NZX37/ESP32Musicplayer/BOM.csv

Item | Qty | Supplier | Cost/item | Total Cost | link
2.25 Inch 2.8V-3.3V TFT LCD Screen ST7789 | 1 | Aliexpress | $6.05 | $6.05 | https://www.aliexpress.com/item/1005009266053584.html
Waveshare ESP32-S3-WROOM-1-N8R8 microcontroller | 1 | Waveshare | $16.88 | $16.88 | https://www.berrybase.de/en/waveshare-esp32-s3-wroom-1-n8r8-microcontroller-aiot-wi-fi-bt-ble-240mhz-dual-core-without-header
PCM5102 I2S DAC with Line Level Output - 112dB SNR | 1 | Adafruit | $4.95 | $4.95 | https://www.adafruit.com/product/6250
DC-DC Step Up Boost Converter | 1 | Kuriosity | $4.40 | $4.40 | https://kuriosity.sg/products/dc-dc-step-up-boost-converter-2-5-vout-to-5-12v-1a-5w
CONN JACK STEREO 3.5MM R/A | 1 | Digikey | $2.22 | $2.22 | https://www.digikey.sg/en/products/detail/same-sky-formerly-cui-devices/SJ1-3535NG/738699
PCB | 1 | JLCPCB | $2.00 | $2.00 | https://jlcpcb.com
PCBA | 1 | jlcpcb | $29.83 | $29.83 | https://jlcpcb.com
Estimated total shipping | 1 |  |  | $0.00
