NZX37/ESP32Musicplayer/Case/LID.stl

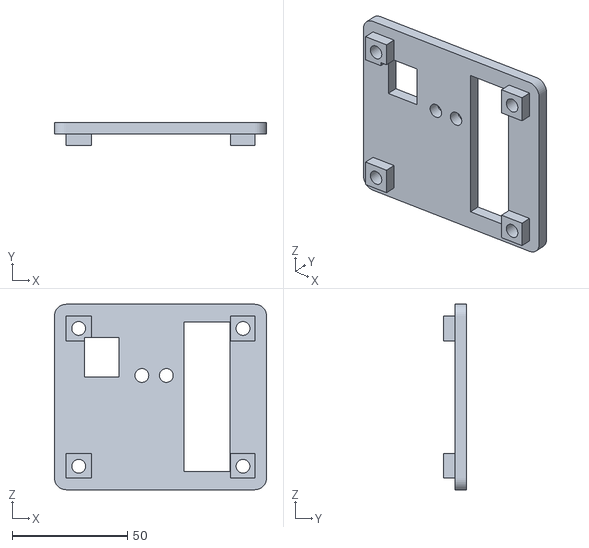
[picture p1: CAD file, 2026-10-25]
Case/LID.stl
92.0 x 10.0 x 80.5
