NZX37/ESP32Musicplayer/Minimusicplayer.step

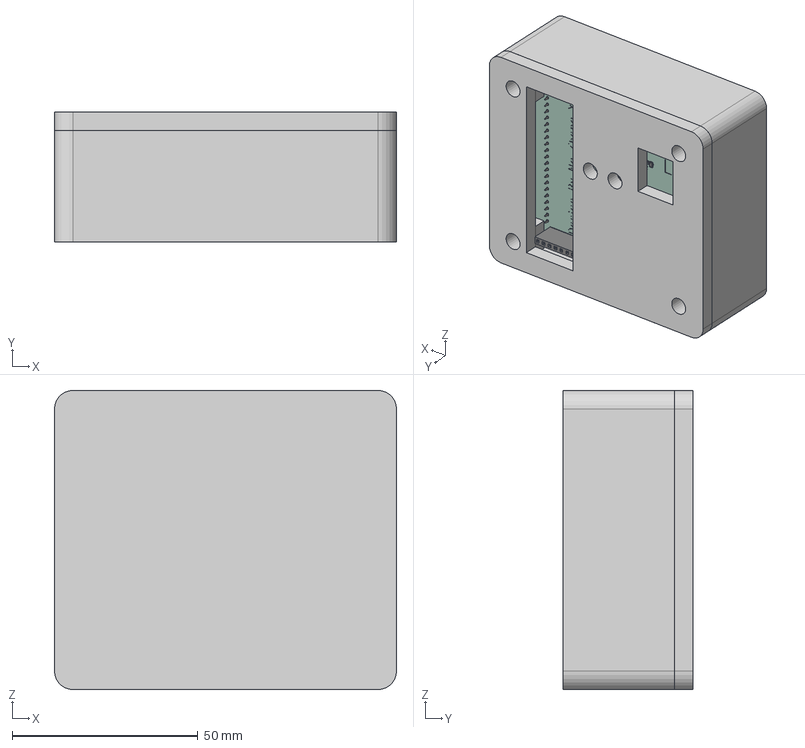
[picture p2: CAD file, 2026-10-25]
Minimusicplayer.step
92.0 x 35.0 x 80.5 mm
R_0805_2012Metric_1 x 8
C_0805_2012Metric_1 x 6
D_DO-41_SOD81_P10.16mm_Horizontal_1
LED_D3.0mm_1 x 2
PinSocket_1x04_P2.54mm_Vertical_1
PinHeader_1x02_P254mm_Vertical
PinSocket_1x08_P2.54mm_Vertical_1
WQFN_16_1EP_3x3mm_P05mm_EP16x16mm
PinSocket_1x22_P2.54mm_Vertical_1 x 2
PinHeader_1x08_P254mm_Vertical
MinF95B_silkscreen
MinF95B_silkscreen_1
MinF95B_PCB
