NZX37/ESP32Musicplayer/Case/CASE.stl

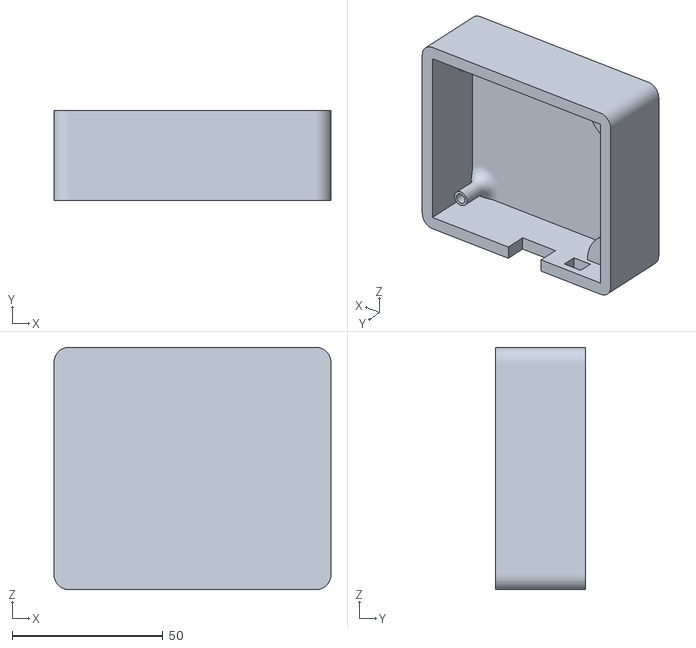
[picture p3: CAD file, 2026-10-25]
Case/CASE.stl
92.0 x 30.0 x 80.5
