NZX37/ESP32Musicplayer/PCB/MiniMusicPlayer.kicad_pcb

## KiCad design PCB/MiniMusicPlayer.kicad_pcb (2026-10-25)

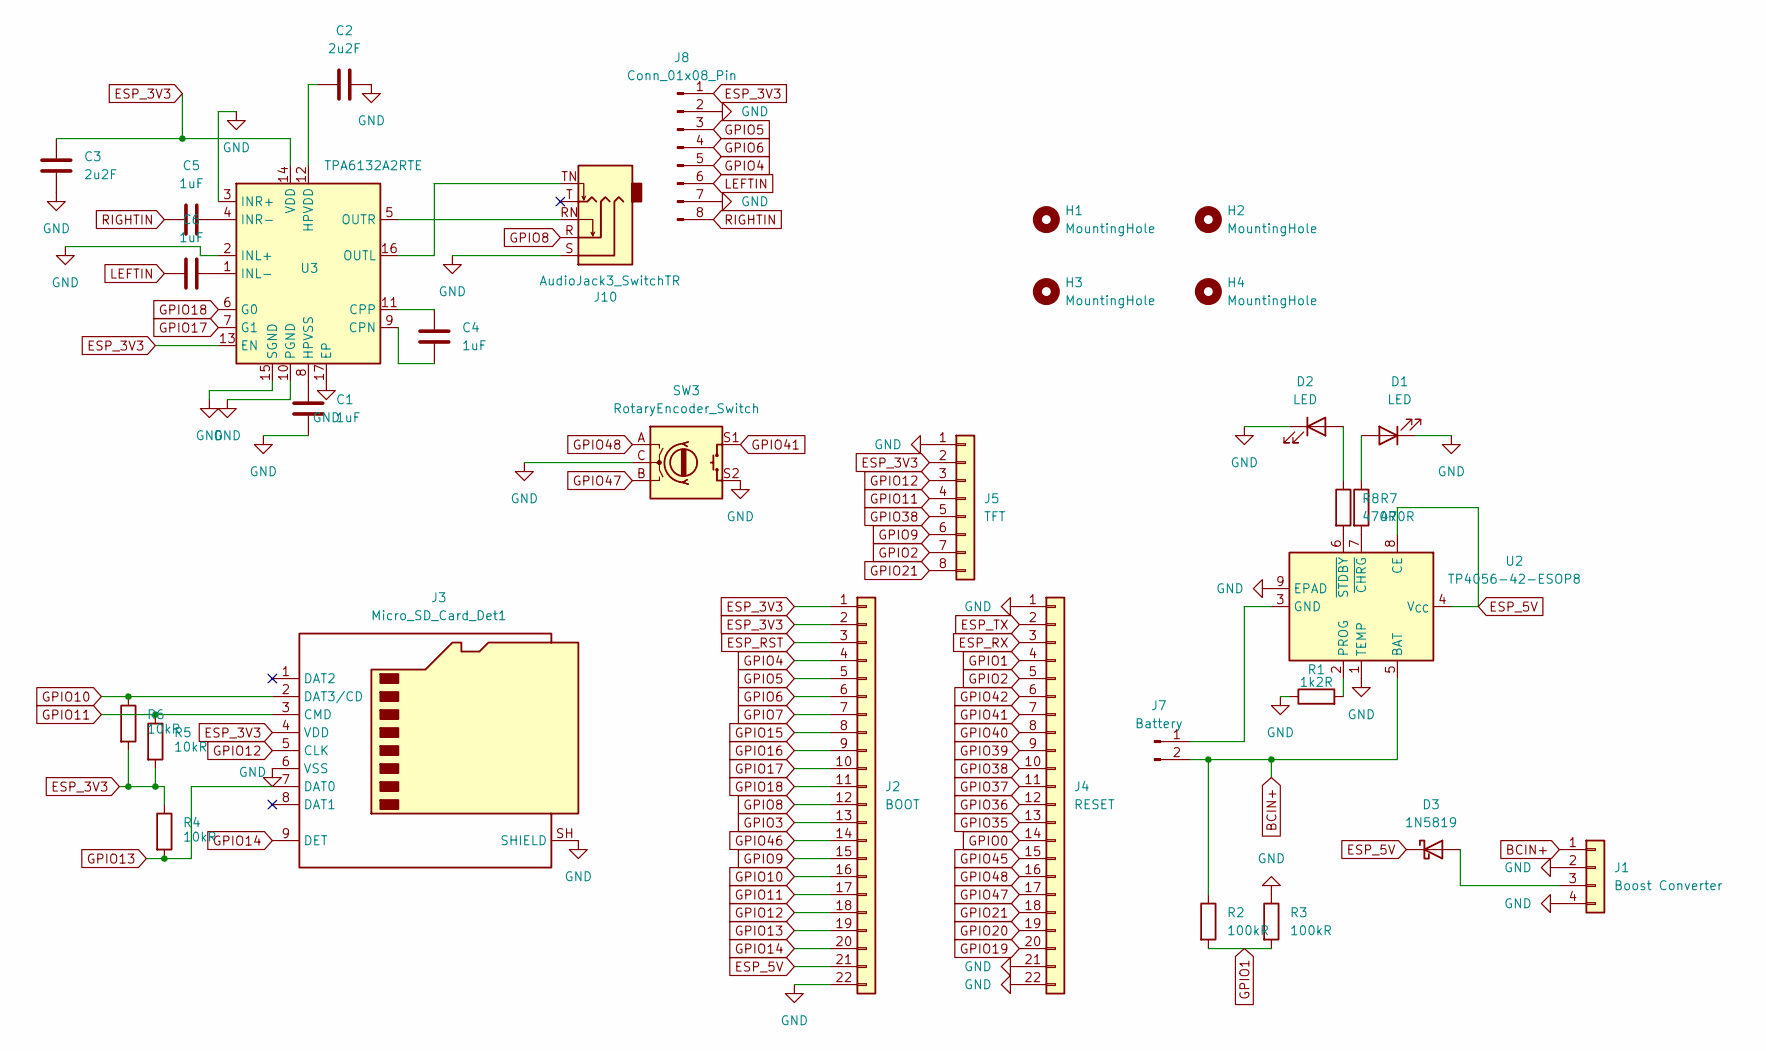
[picture p4: schematic MiniMusicPlayer.kicad_sch]

Parts:
C1, C4, C5, C6: 1uF; C_0805_2012Metric_Pad1.18x1.45mm_HandSolder
C2, C3: 2u2F; C_0805_2012Metric_Pad1.18x1.45mm_HandSolder
D1, D2: LED; LED_D3.0mm
D3: 1N5819; D_DO-41_SOD81_P10.16mm_Horizontal
H1, H2, H3, H4: MountingHole; MountingHole_3.2mm_M3
J1: Boost Converter; PinSocket_1x04_P2.54mm_Vertical
J2: BOOT; PinSocket_1x22_P2.54mm_Vertical
J3: Micro_SD_Card_Det1; microSD_HC_Molex_104031-0811
J4: RESET; PinSocket_1x22_P2.54mm_Vertical
J5: TFT; PinSocket_1x08_P2.54mm_Vertical
J7: Battery; PinHeader_1x02_P2.54mm_Vertical
J8: Conn_01x08_Pin; PinHeader_1x08_P2.54mm_Vertical
J10: AudioJack3_SwitchTR; Jack_3.5mm_CUI_SJ1-3535NG_Horizontal
R1: 1k2R; R_0805_2012Metric_Pad1.20x1.40mm_HandSolder
R2, R3: 100kR; R_0805_2012Metric_Pad1.20x1.40mm_HandSolder
R4, R5, R6: 10kR; R_0805_2012Metric_Pad1.20x1.40mm_HandSolder
R7, R8: 470R; R_0805_2012Metric_Pad1.20x1.40mm_HandSolder
SW3: RotaryEncoder_Switch; RotaryEncoder_Alps_EC12E-Switch_Vertical_H20mm
U2: TP4056-42-ESOP8; SOIC-8-1EP_3.9x4.9mm_P1.27mm_EP2.41x3.3mm_ThermalVias
U3: TPA6132A2RTE; WQFN-16-1EP_3x3mm_P0.5mm_EP1.6x1.6mm_ThermalVias

Connections:
BCIN+: J1.1, J7.2, R2.1, U2.5 (BAT)
ESP_3V3: C3.2, J2.1, J2.2, J3.4 (VDD), J5.2, J8.1, R4.1, R5.2, R6.2, U3.13 (EN), U3.14 (VDD)
ESP_5V: D3.1 (K), J2.21, U2.4 (V_{CC}), U2.8 (CE)
ESP_RST: J2.3
ESP_RX: J4.3
ESP_TX: J4.2
GND: C1.2, C2.2, C3.1, D1.1 (K), D2.1 (K), J1.2, J1.4, J2.22, J3.6 (VSS), J3.SH (SHIELD), J4.1, J4.21, J4.22, J5.1, J8.2, J8.7, J10.S, R1.1, R3.1, SW3.C, SW3.S2, U2.1 (TEMP), U2.9 (EPAD), U3.2 (INL+), U3.3 (INR+), U3.10 (PGND), U3.15 (SGND), U3.17 (EP)
GPIO0: J4.14
GPIO1: J4.4, R2.2, R3.2
GPIO2: J4.5, J5.7
GPIO3: J2.13
GPIO4: J2.4, J8.5
GPIO5: J2.5, J8.3
GPIO6: J2.6, J8.4
GPIO7: J2.7
GPIO8: J2.12, J10.R
GPIO9: J2.15, J5.6
GPIO10: J2.16, J3.2 (DAT3/CD), R6.1
GPIO11: J2.17, J3.3 (CMD), J5.4, R5.1
GPIO12: J2.18, J3.5 (CLK), J5.3
GPIO13: J2.19, J3.7 (DAT0), R4.2
GPIO14: J2.20, J3.9 (DET)
GPIO15: J2.8
GPIO16: J2.9
GPIO17: J2.10, U3.7 (G1)
GPIO18: J2.11, U3.6 (G0)
GPIO19: J4.20
GPIO20: J4.19
GPIO21: J4.18, J5.8
GPIO35: J4.13
GPIO36: J4.12
GPIO37: J4.11
GPIO38: J4.10, J5.5
GPIO39: J4.9
GPIO40: J4.8
GPIO41: J4.7, SW3.S1
GPIO42: J4.6
GPIO45: J4.15
GPIO46: J2.14
GPIO47: J4.17, SW3.B
GPIO48: J4.16, SW3.A
LEFTIN: C6.2, J8.6
unnamed: D1.2 (A), R7.1
unnamed: D2.2 (A), R8.1
unnamed: D3.2 (A), J1.3
unnamed: J7.1, U2.3 (GND)
unnamed: R1.2, U2.2 (PROG)
unnamed: R7.2, U2.7 (~CHRG)
unnamed: R8.2, U2.6 (~STDBY)
unnamed: C4.2, U3.9 (CPN)
unnamed: C4.1, U3.11 (CPP)
unnamed: C2.1, U3.12 (HPVDD)
unnamed: C1.1, U3.8 (HPVSS)
unnamed: C6.1, U3.1 (INL-)
unnamed: C5.1, U3.4 (INR-)
unnamed: J10.TN, U3.16 (OUTL)
unnamed: J10.RN, U3.5 (OUTR)
RIGHTIN: C5.2, J8.8

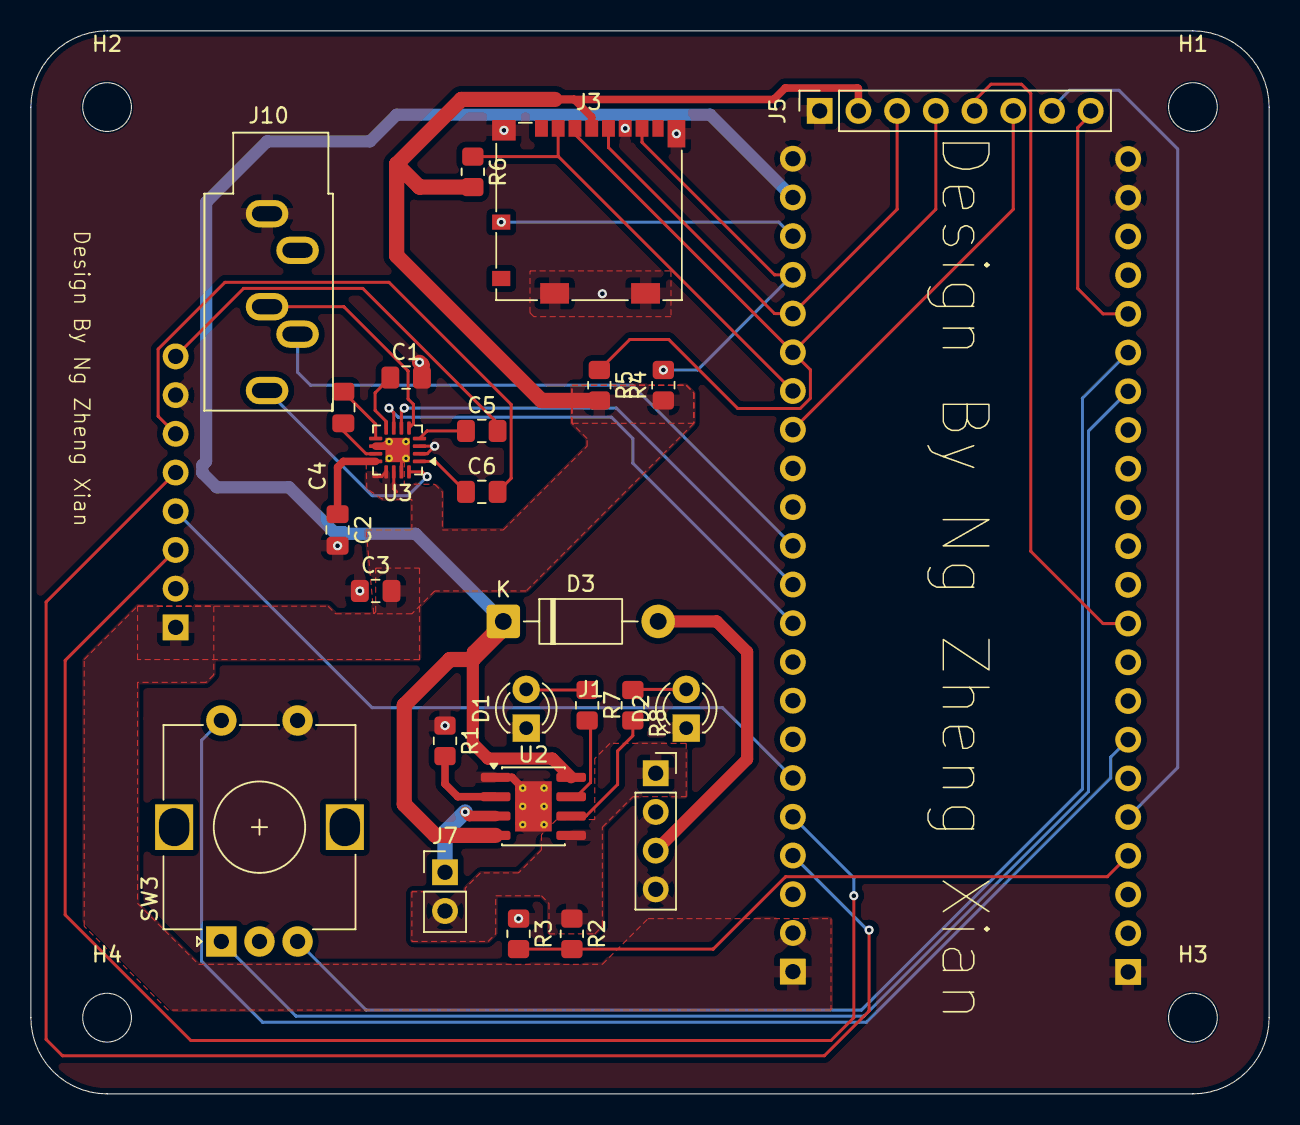
[picture p5: board MiniMusicPlayer.kicad_pcb from above]

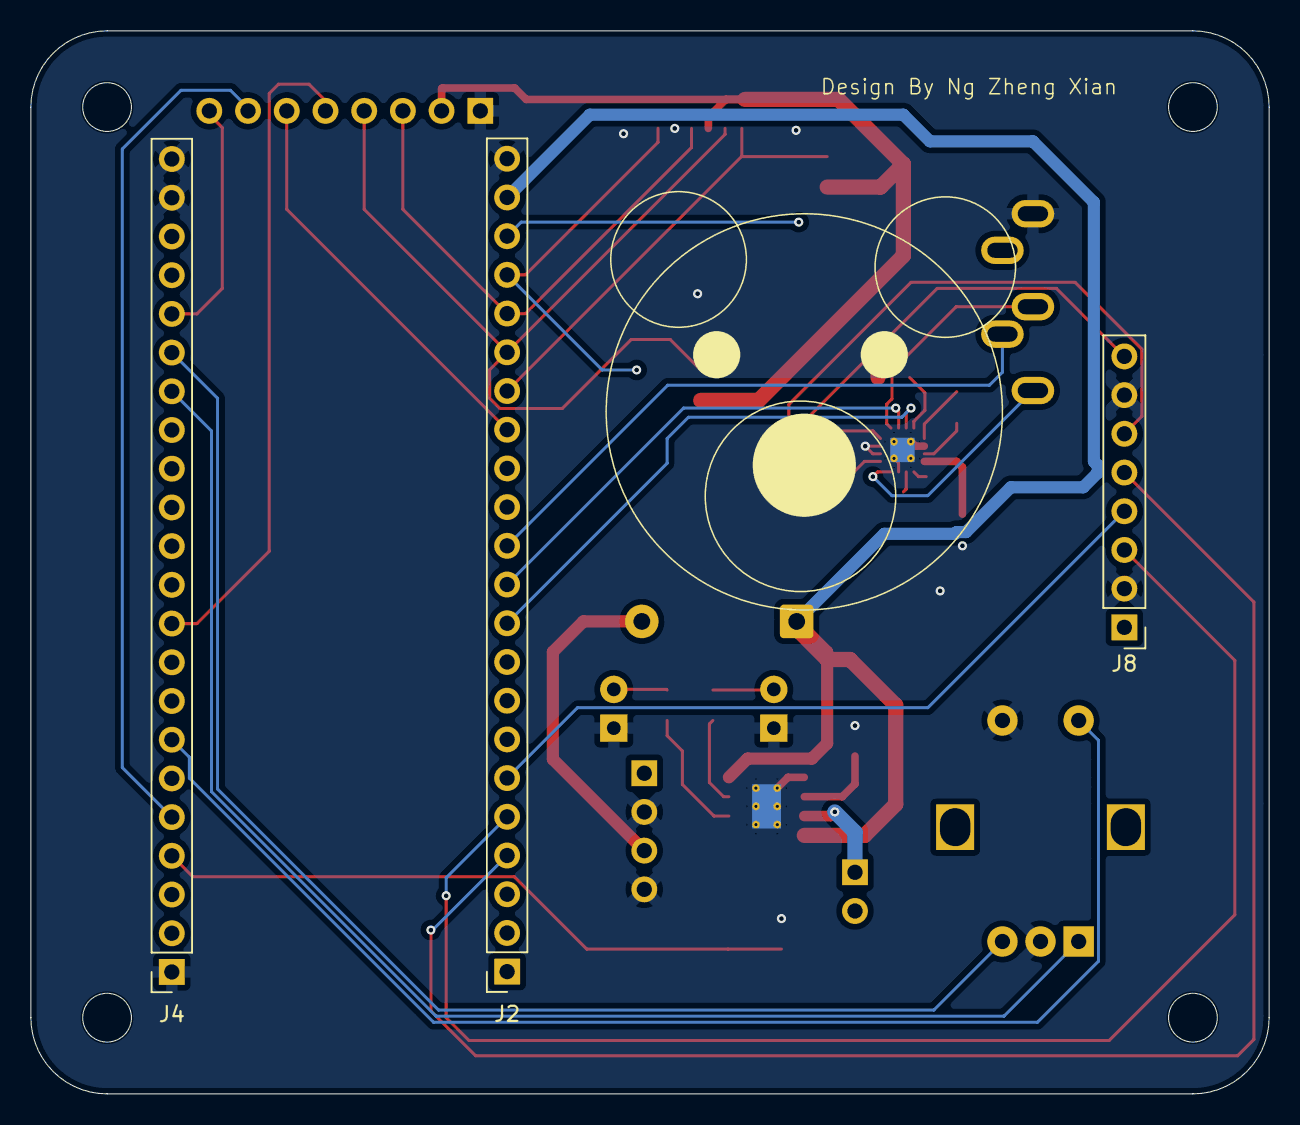
[picture p6: board MiniMusicPlayer.kicad_pcb from below]

Board: 2 copper layers, 81.2 x 69.8 mm, 32 parts (3 on the bottom side), 40 nets.
