NZX37/ESP32Musicplayer/JOURNAL.md

# Mini music player – devlog

<!-- Generated by Half Life from project cmvermh6j09z701rcc8w4absv. Edits here are overwritten on the next sync. -->
<!-- Generated: 2026-10-25T13:52:36.797Z -->

> [!NOTE]
> This devlog is mirrored from [Half Life](https://halflife.hackclub.com) – [open the project](https://halflife.hackclub.com/projects/cmvermh6j09z701rcc8w4absv). Editing it here will not change the platform's copy, and the next sync overwrites this file.

> An ESP32 powered audio player using micro SD storage with a headphone jack.

| Week | Tier | Hours logged | Entries |
| --- | --- | --- | --- |
| Week 3 | Tier 2 | 13h | 3 |

## Contents

1. [2026-10-24 – # Planning and Schematic!](#2026-10-24-planning-and-schematic)
2. [2026-10-25 – # PCBing](#2026-10-25-pcbing)
3. [2026-10-25 – # CAD for casing](#2026-10-25-cad-for-casing)

## Design

### 2026-10-24 – # Planning and Schematic!

**6h**

# Planning and Schematic!

## tl;dr
I planned out my design, finished the schematic and footprint assignments!
## Planning
My basic idea is using [esp32 S3](https://www.berrybase.de/en/waveshare-esp32-s3-wroom-1-n8r8-microcontroller-aiot-wi-fi-bt-ble-240mhz-dual-core-without-header) and [PCM5102](https://www.adafruit.com/product/6250) with [TPA6132A2](https://www.ti.com/lit/ds/symlink/tpa6132a2.pdf?ts=1792813412028) and some power management with [boost converter](https://kuriosity.sg/products/dc-dc-step-up-boost-converter-2-5-vout-to-5-12v-1a-5w) and TP4056.
## Schematic
This was mainly reading documentation after documentation and praying the circuit would not blow up. :D

This is the wiring i used for the TPA


audio wiring!


microsd card wiring


power management


esp32 and screen!

Full schematic!!!
## footprints

The important part for this is to consider if i can hand solder these(I will be using PCBA for the modules tho)

### 2026-10-25 – # PCBing

**4h**

# PCBing

## Layout


I spread the components around to make sure the layout is right, ensure decoupling caps and resistors are near their pins and minimize overlaps


Some routing finished for FCu


Power side wiring done!


Full PCB Done!

## Next steps
CAD and export files!

### 2026-10-25 – # CAD for casing

**3h**

# CAD for casing
## importing the PCB!


This was basically just exporting the step and inserting it. the component and data panel gave me some trouble however.

## Case


Bottom part

## Lid



Top part!

## Screws


this is a place for heat set inserts!
