NZX37/ESP32Musicplayer/(commit log)

2026-10-25 FILES: upload PCB
    [MiniMusicPlayer.kicad_pcb, MiniMusicPlayer.kicad_sch]
2026-10-25 FILES: upload stl
    [CASE.stl, LID.stl]
2026-10-25 Sync Mini music player from Half Life
    [BOM.csv]
